Magnotta/rast/rast/pins.h

const byte driverIn1 = 3;
const byte driverIn2 = 5;
const byte driverIn3 = 9;
const byte driverIn4 = 10;

const byte encAzimD1 = 49;
const byte encAzimD2 = 47;
const byte encElevD1 = 51;
const byte encElevD2 = 53;

const byte ldrUR = A0;
const byte ldrUL = A1;
const byte ldrDR = A3;
const byte ldrDL = A2;

const byte rotEncCk = 22;
const byte rotEncDT = 24;
const byte rotEncSw = 26;
