Magnotta/rast/(commit log)

2022-09-02 Análise de dados e geração de trajetória
2026-02-12 visual update to the github project
    [azimuth_sunrise_table.csv, azimuth_table.csv, elevation_table.csv, test_results.csv]
